zhangjw-THU/AI-Car/README.md

# Intelligent-Car
电子技术实验课程设计——智能小车
主要设计数字传感器的应用
