zhangjw-THU/AI-Car/(list of files, drawings)

Other design files:
PCB/PCB_Motor_D_Part/BTS7960B.PcbLib
PCB/PCB_Motor_D_Part/PCB1.PcbDoc
PCB/PCB_Motor_D_Part/PCB1_REOUT.pcb
PCB/PCB_Motor_D_Part/PCB_Motor_D_Part.PrjPcb
PCB/PCB_Power_S_M_Part/PCB1.pcb
PCB/PCB_Power_S_M_Part/PCB1.PcbDoc
PCB/PCB_Power_S_M_Part/PCB1_REOUT.pcb
PCB/PCB_Power_S_M_Part/PCB_Power_S_M_Part.PrjPcb
PCB/PCB_Power_S_M_Part/Sheet1.SchDoc
